michaelkearney55/embedded-maglev/demo.jpeg

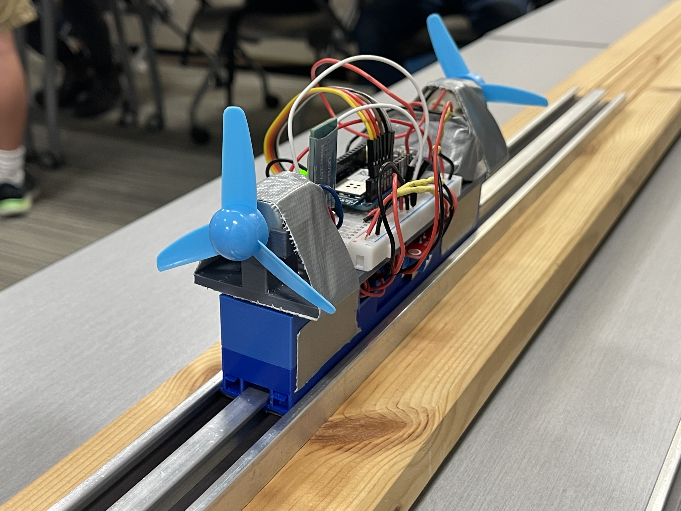
demo.jpeg
