michaelkearney55/embedded-maglev/models/train/with-assets.png

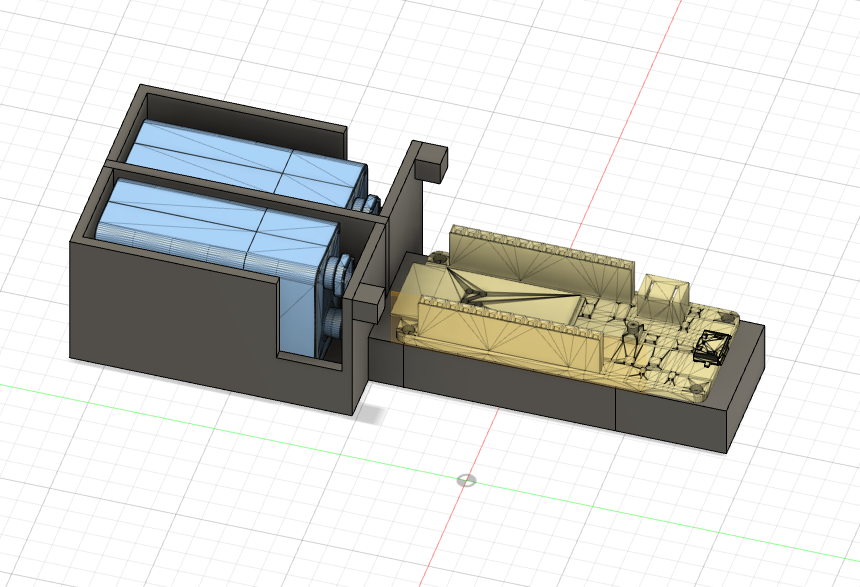
models/train/with-assets.png
