michaelkearney55/embedded-maglev/README.md

# embedded-maglev

Access most documents on [Google Drive](https://drive.google.com/drive/folders/1p7idVl7kjI17cJOBbpHi_xSPKCr0PSQH) or see the [final report](https://docs.google.com/document/d/1XEHepR6jj1Q5RTBn2oZJXVBXAFL0Ju1zqQ4ZtrlpB74/edit) for install and testing instructions.
