michaelkearney55/embedded-maglev/models/canonical_track.png

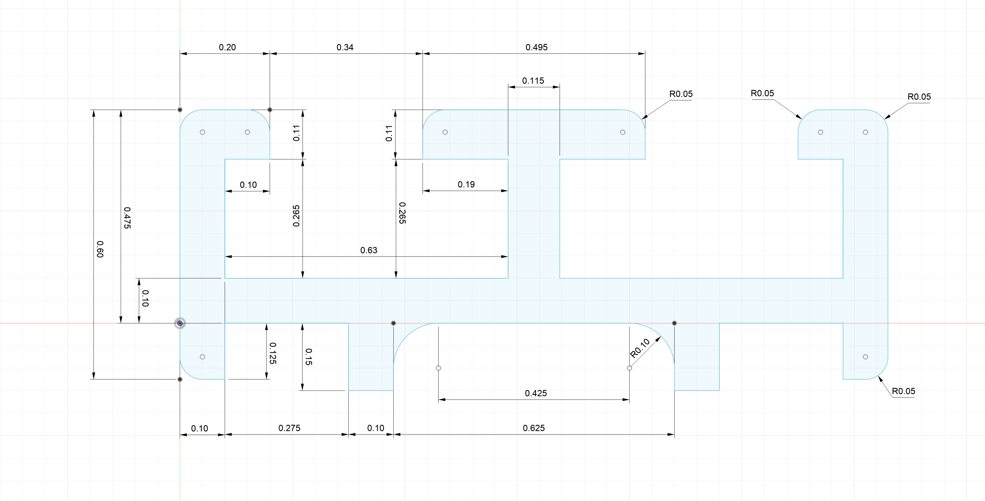
models/canonical_track.png
