michaelkearney55/embedded-maglev/models/train/without-assets.png

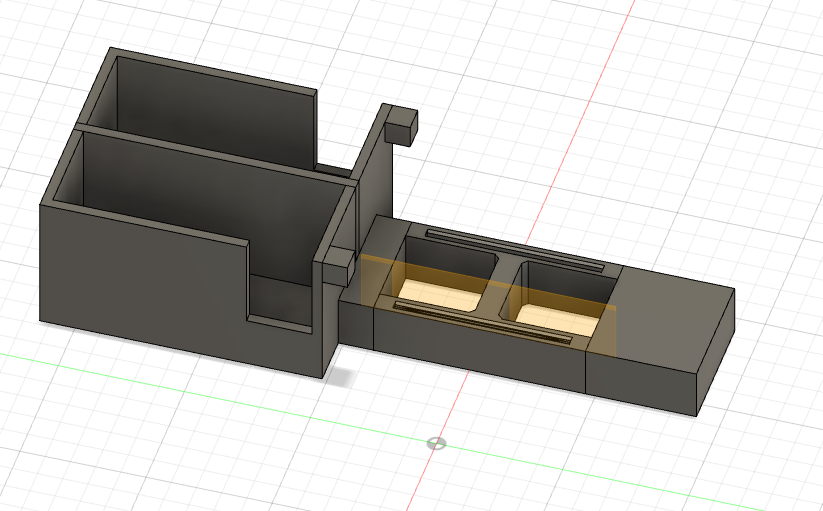
models/train/without-assets.png
