michaelkearney55/embedded-maglev/models/track_joiner.stl

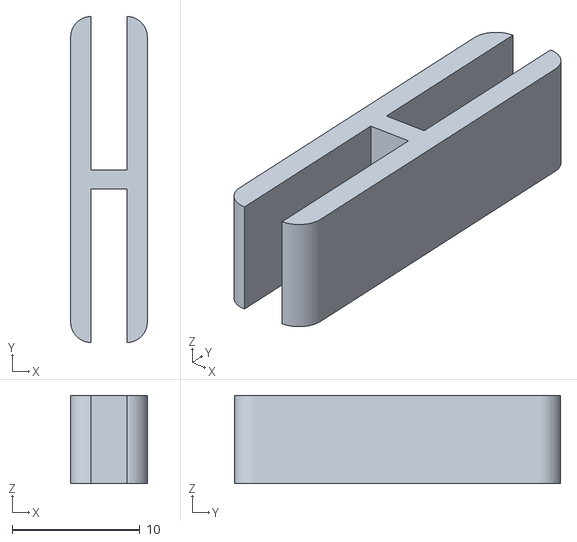
[picture p12: CAD file, 2023-10-23]
models/track_joiner.stl
6.00 x 25.5 x 6.90
