michaelkearney55/embedded-maglev/models/train/newlid.stl

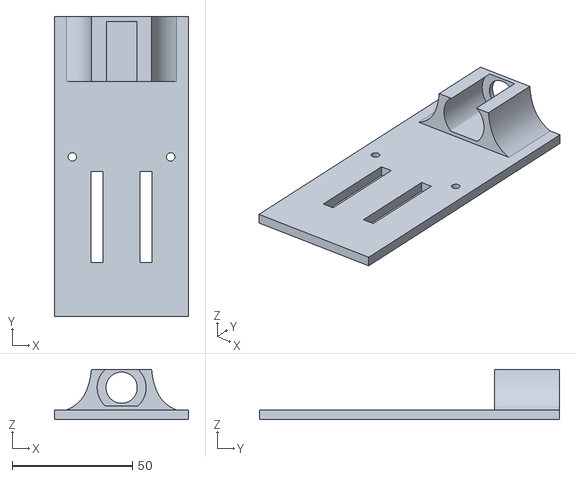
[picture p13: CAD file, 2023-10-24]
models/train/newlid.stl
56.0 x 125.0 x 21.0
