michaelkearney55/embedded-maglev/models/canonical_track.stl

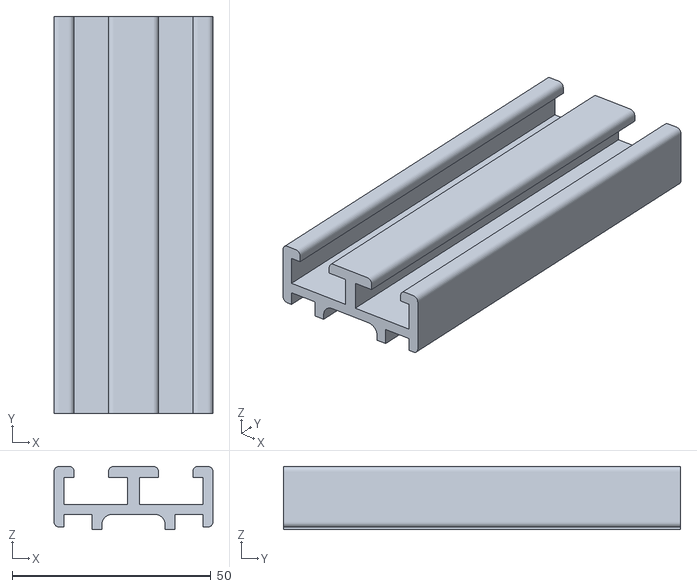
[picture p14: CAD file, 2023-10-23]
models/canonical_track.stl
40.0 x 100.0 x 15.9
