michaelkearney55/embedded-maglev/models/train/train-rail-and-arduino.stl

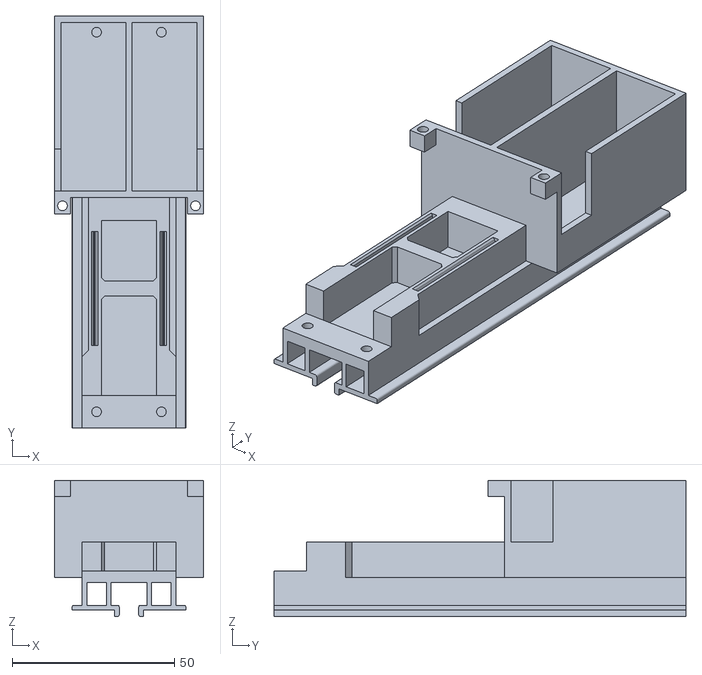
[picture p15: CAD file, 2023-10-24]
models/train/train-rail-and-arduino.stl
46.0 x 127.0 x 42.0
