michaelkearney55/embedded-maglev/models/sled.stl

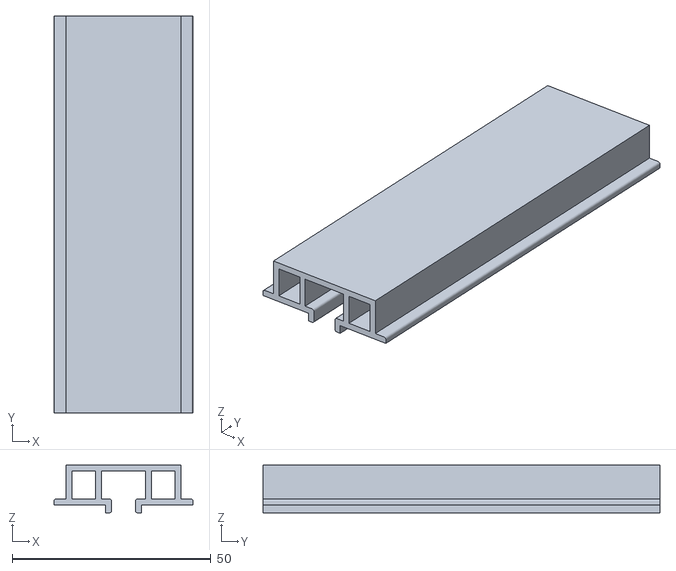
[picture p16: CAD file, 2023-10-23]
models/sled.stl
35.0 x 100.0 x 12.0
