michaelkearney55/embedded-maglev/(commit log)

2023-10-22 feat: added sled model and directory structure
    [sled_mm.f3d]
2023-10-23 feat: added canonical track
    [canonical_track v1.f3d]
2023-10-23 feat: added track joiner model and track diagram; add models as .stl
    [canonical_track v1.f3d, canonical_track.stl, sled.stl, sled_mm.f3d, track_joiner.stl]
2023-10-24 Add stl files for the train model
    [newlid.stl, train-rail-and-arduino.stl]
2023-12-09 Rename for arduino files
2023-12-17 added motor adapter models and demo photo
